NguyenTuanPhong2002/PID-HEADER/HEATER SYSTEM PID/Schematic Prints.pdf

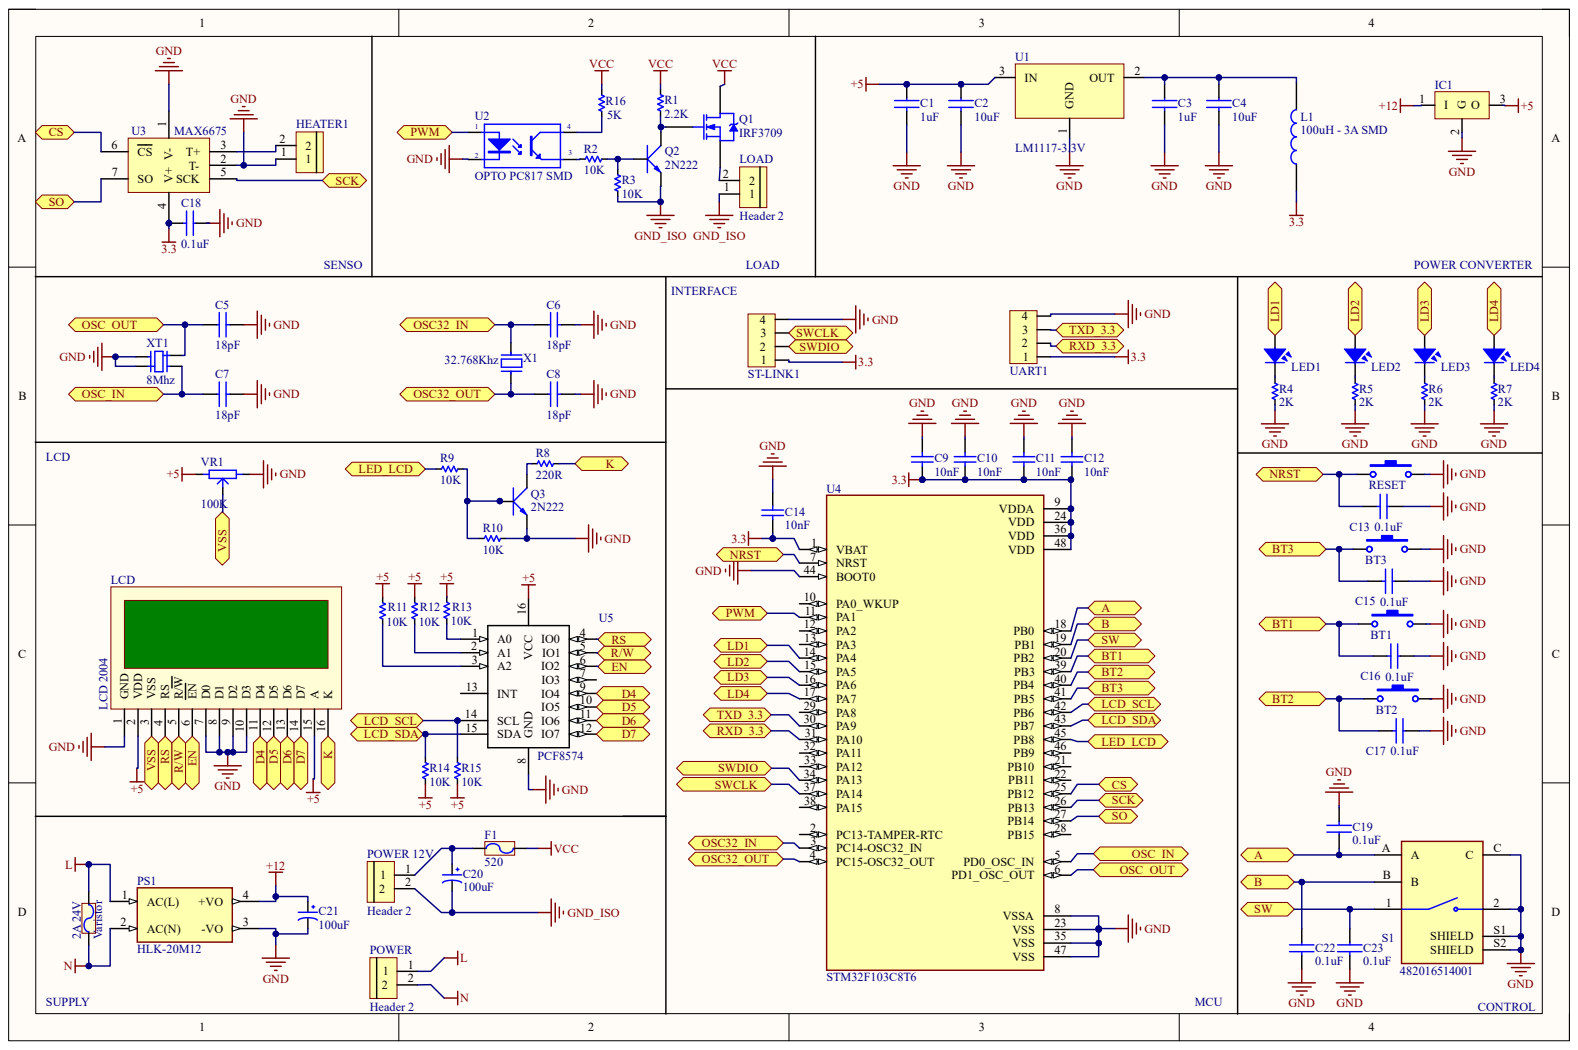
[picture p1: page 1]
