NguyenTuanPhong2002/PID-HEADER/(list of files, drawings)

Other design files:
HEATER SYSTEM PID/HEATER SYSTEM PID.PrjPcb
HEATER SYSTEM PID/PCB1.PcbDoc
HEATER SYSTEM PID/Sheet1.SchDoc
