NguyenTuanPhong2002/PID-HEADER/HEATER SYSTEM PID/CODE/Core/Src/main.c

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
/* Includes ------------------------------------------------------------------*/
#include "main.h"

/* USER CODE BEGIN Includes */
#include "application.h"
/* USER CODE END Includes */

I2C_HandleTypeDef hi2c1;

RTC_HandleTypeDef hrtc;

SPI_HandleTypeDef hspi2;

TIM_HandleTypeDef htim2;

UART_HandleTypeDef huart1;

/* USER CODE BEGIN PV */
CLCD_I2C_Name LCD1;

PIDController pid;

uint32_t encoderCount = 60;
float powerpoint = 1.0f;
uint32_t realValue = 0;
uint8_t dir = 0;
uint64_t timestap = 0;
uint64_t sw_timestap = 0;
uint8_t status = 0;
uint8_t clsmoniter = 0;
double control_signal = 0;
/* USER CODE END PV */

void SystemClock_Config(void);
static void MX_GPIO_Init(void);
static void MX_I2C1_Init(void);
static void MX_USART1_UART_Init(void);
static void MX_SPI2_Init(void);
static void MX_RTC_Init(void);
static void MX_TIM2_Init(void);
/* USER CODE BEGIN 0 */
void HAL_GPIO_EXTI_Callback(uint16_t GPIO_Pin) {
	if (GPIO_Pin == GPIO_PIN_2 && (HAL_GetTick() - sw_timestap) > 1000) {
		if (status == 0) {
			status = 1;
			//clsmoniter = 1;
			initTime();
			PID_Init(&pid, 1.0, 0.1, 0.01, encoderCount);
		} else if (status == 1) {
			initTime();
			status = 2;
			clsmoniter = 1;
		} else if (status == 2) {
			status = 0;
			clsmoniter = 1;
		}
		sw_timestap = HAL_GetTick();
	}

	if (status == 0 || status == 1) {

		if ((HAL_GetTick() - timestap) > 100)
			dir = 0;
		if (GPIO_Pin == GPIO_PIN_1 && dir == 0
				|| GPIO_Pin == GPIO_PIN_1 && dir == 1) {
			encoderCount++;
			PID_Init(&pid, 1.0, 0.1, 0.01, encoderCount);
			HAL_GPIO_TogglePin(LD3_GPIO_Port, LD3_Pin);
			dir = 1;
			timestap = HAL_GetTick();
		}
		if (GPIO_Pin == GPIO_PIN_0 && dir == 0
				|| GPIO_Pin == GPIO_PIN_0 && dir == 2) {
			if (encoderCount > 0) {
				encoderCount--;
				PID_Init(&pid, 1.0, 0.1, 0.01, encoderCount);
			}
			HAL_GPIO_TogglePin(LD2_GPIO_Port, LD2_Pin);
			dir = 2;
			timestap = HAL_GetTick();
		}
	}

	if (status == 2) {

		if ((HAL_GetTick() - timestap) > 100)
			dir = 0;
		if (GPIO_Pin == GPIO_PIN_1 && dir == 0
				|| GPIO_Pin == GPIO_PIN_1 && dir == 1) {
			powerpoint = powerpoint + 0.05f;
			//PID_Init(&pid, 1.0, 0.1, 0.01, encoderCount);
			HAL_GPIO_TogglePin(LD3_GPIO_Port, LD3_Pin);
			dir = 1;
			timestap = HAL_GetTick();
		}
		if (GPIO_Pin == GPIO_PIN_0 && dir == 0
				|| GPIO_Pin == GPIO_PIN_0 && dir == 2) {
			if (powerpoint > 0.9f) {
				powerpoint = powerpoint - 0.05f;
				//PID_Init(&pid, 1.0, 0.1, 0.01, encoderCount);
			}
			HAL_GPIO_TogglePin(LD2_GPIO_Port, LD2_Pin);
			dir = 2;
			timestap = HAL_GetTick();
		}
	}
}

int pwmtime;
void pwm_output(int pwm) {
	if (pwm <= 0) {
		HAL_GPIO_WritePin(PWM_GPIO_Port, PWM_Pin, 1);
		HAL_GPIO_WritePin(LD4_GPIO_Port, LD4_Pin, 1);
		HAL_Delay(250);
	} else if (pwm >= 100) {
		HAL_GPIO_WritePin(PWM_GPIO_Port, PWM_Pin, 0);
		HAL_GPIO_WritePin(LD4_GPIO_Port, LD4_Pin, 0);
		HAL_Delay(250);
	} else {
		pwmtime = 100 - pwm;
		if (pwmtime == 0) {
			pwmtime = 1;
		}
		for (int i = 0; i < 3; i++) {
			HAL_GPIO_WritePin(PWM_GPIO_Port, PWM_Pin, 0);
			HAL_GPIO_WritePin(LD4_GPIO_Port, LD4_Pin, 0);
			HAL_Delay(pwm);
			HAL_GPIO_WritePin(PWM_GPIO_Port, PWM_Pin, 1);
			HAL_GPIO_WritePin(LD4_GPIO_Port, LD4_Pin, 1);
			HAL_Delay(pwmtime);
		}
	}

}

void powerPID() {

}
/* USER CODE END 0 */

/**
 * @brief  The application entry point.
 * @retval int
 */
int main(void) {
	/* MCU Configuration--------------------------------------------------------*/

	/* Reset of all peripherals, Initializes the Flash interface and the Systick. */
	HAL_Init();

	/* Configure the system clock */
	SystemClock_Config();

	/* Initialize all configured peripherals */
	MX_GPIO_Init();
	MX_I2C1_Init();
	MX_USART1_UART_Init();
	MX_SPI2_Init();
	MX_RTC_Init();
	MX_TIM2_Init();
	/* USER CODE BEGIN 2 */

	HAL_GPIO_WritePin(PWM_GPIO_Port, PWM_Pin, 1);

	initApp();
	MAX6675_Init();

	mainMenu();
	initTime();

	/* Create the object*/

// char *message = "Hello, UART!\r\n";
// HAL_UART_Transmit(&huart1, (uint8_t *)message, strlen(message),
// 				  HAL_MAX_DELAY);
	/* USER CODE END 2 */

	/* Infinite loop */
	/* USER CODE BEGIN WHILE */
	while (1) {
		/* USER CODE END WHILE */

		/* USER CODE BEGIN 3 */
		HAL_GPIO_TogglePin(LD1_GPIO_Port, LD1_Pin);
		if (clsmoniter == 1) {
			CLCD_I2C_Clear(&LCD1);
			clsmoniter = 0;
		}

		if (status == 1) {
			updateSetpoint(encoderCount);
			updateStatus(status);

			/* Functions */
			realValue = getTem();
			updateRealValue(realValue);
			control_signal = PID_Update(&pid, realValue);
			if (realValue > encoderCount) {
				pwm_output(-1);
			} else {
				pwm_output(control_signal);
			}
			updateTime();
		} else if (status == 0) {
			mainMenu();
			pwm_output(-1);
			updateSetpoint(encoderCount);
			updateStatus(status);

			/* Functions */
			realValue = getTem();
			updateRealValue(realValue);
			HAL_Delay(200);
		} else if (status == 2) {
			mainPower();
			updatePowerpoint(powerpoint);
			realValue = getTem();
			updateRealValue(realValue);
			pwm_output((int) (powerpoint * 5.8f));
			updateTime();
		}
	}
	/* USER CODE END 3 */
}

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
