NguyenTuanPhong2002/PID-HEADER/(commit log)

2023-11-05 read encoder NTPhong
2023-11-05 pid NTPhong
2024-01-24 new set up ioc in stm32 ide
