NguyenTuanPhong2002/PID-HEADER/(notices)

Notices in the files:
HEATER SYSTEM PID/CODE/Core/Inc/main.h:
Copyright (c) 2023 STMicroelectronics.
All rights reserved.
This software is licensed under terms that can be found in the LICENSE file
